radioation/AtariRaider/(commit log)

2026-07-01 Initial upload of arduino firmware
2026-07-08 flipping axis to match Star Raiders analog code
    [raider.ino]
2026-07-08 updating circuit
2026-07-14 restart comparator if hline appears stuck
    [raider.ino]
2026-07-14 starting raider/viper full test
    [atari-xex.cfg]
2026-07-14 fixing button and player positioning in A8 test
    [main.c]
2026-07-19 working on calibration
2026-07-23 updating circuit w/ calib button, 5V supply diode
2026-07-24 updating voltage to pots
